picorubykaigi/adventure-board-pcb/production/pv1/bom.csv

Designator | Footprint | Quantity | Value | LCSC Part #
C1, C26, C3, C31, C32, C35, C36 | 0805 | 7 | 10uF | C1713
C10, C11, C12, C13, C14, C15, C16, C18, C19, C2, C23, C24, C28, C29, C30, C37, C38, C9 | 0402 | 18 | 100nF | C1525
C20, C21 | 0402 | 2 | 15pF | C1548
C22, C25 | 0402 | 2 | 3.3nF | C3881585
C27, C33, C34 | 0402 | 3 | 1uF | C52923
C4 | 0805 | 1 | 22uF | C45783
C5, C6, C7, C8 | 0402 | 4 | 4.7uF | C23733
D2 | 0603 | 1 | LED RED | C2286
D3 | 0805 | 1 | LED GREEN | C2297
J1 | PinSocket_2x10_P2.54mm_Vertical | 1 | BreadboardHdr_2x10 | C2897411
J4, J5 | CONN-SMD_HY2.0-4P | 2 | HY2.0-4P-WT | C722729
L1 | IND-SMD_L2.0-W1.6_AOTA-B201610S3R3-101-T | 1 | 3.3uH | C42411119
LED1, LED10, LED100, LED101, LED102, LED103, LED104, LED105, LED106, LED107, LED108, LED109, LED11, LED110, LED111, LED112, LED113, LED114, LED115, LED116, LED117, LED118, LED119, LED12, LED120, LED121, LED122, LED123, LED124, LED125, LED126, LED127, LED128, LED129, LED13, LED130, LED131, LED132, LED133, LED134, LED135, LED136, LED137, LED138, LED139, LED14, LED140, LED141, LED142, LED143, LED144, LED145, LED146, LED147, LED148, LED149, LED15, LED150, LED151, LED152, LED153, LED154, LED155, LED156, LED157, LED158, LED159, LED16, LED160, LED161, LED162, LED163, LED164, LED165, LED166, LED167, LED168, LED169, LED17, LED170, LED171, LED172, LED173, LED174, LED175, LED176, LED177, LED178, LED179, LED18, LED180, LED181, LED182, LED183, LED184, LED185, LED186, LED187, LED188, LED189, LED19, LED190, LED191, LED192, LED193, LED194, LED195, LED196, LED197, LED198, LED199, LED2, LED20, LED200, LED201, LED202, LED203, LED204, LED205, LED206, LED207, LED208, LED209, LED21, LED210, LED211, LED212, LED213, LED214, LED215, LED216, LED217, LED218, LED219, LED22, LED220, LED221, LED222, LED223, LED224, LED225, LED226, LED227, LED228, LED229, LED23, LED230, LED231, LED232, LED233, LED234, LED235, LED236, LED237, LED238, LED239, LED24, LED240, LED241, LED242, LED243, LED244, LED245, LED246, LED247, LED248, LED249, LED25, LED250, LED251, LED252, LED253, LED254, LED255, LED256, LED26, LED27, LED28, LED29, LED3, LED30, LED31, LED32, LED33, LED34, LED35, LED36, LED37, LED38, LED39, LED4, LED40, L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 | LED_0402_Compact_P1.6mm | 200 | LED_W | C20613596
LED49, LED5, LED50, LED51, LED52, LED53, LED54, LED55, LED56, LED57, LED58, LED59, LED6, LED60, LED61, LED62, LED63, LED64, LED65, LED66, LED67, LED68, LED69, LED7, LED70, LED71, LED72, LED73, LED74, LED75, LED76, LED77, LED78, LED79, LED8, LED80, LED81, LED82, LED83, LED84, LED85, LED86, LED87, LED88, LED89, LED9, LED90, LED91, LED92, LED93, LED94, LED95, LED96, LED97, LED98, LED99 | LED_0402_Compact_P1.6mm | 56 | LED_W | C20613596
LS1 | BUZ-SMD_4P-L13.0-W13.0-P11.4-BL | 1 | SPK_8R_0.7W | C18186315
R1, R2 | 0402 | 2 | 5.1k | C25905
R10, R14, R43, R7, R8 | 0402 | 5 | 1k | C11702
R11, R12 | 0402 | 2 | 2.2k | C25879
R13, R15, R29, R30 | 0402 | 4 | 4.7k | C25900
R17, R18 | 0402 | 2 | 33k | C25779
R19, R24, R33, R34, R35, R36, R37, R38 | 0402 | 8 | 10k | C25744
R20, R21, R22, R23 | 0402 | 4 | 22 | C25092
R25, R27, R28, R48, R49 | 0603 | 5 | 0 | C21189
R3, R4 | 0402 | 2 | 27 | C25100
R31, R32 | 0402 | 2 | 2k | C4109
R5 | 0402 | 1 | 33 | C25105
R6, R9 | 0402 | 2 | 47k | C25792
SW1, SW2, SW3, SW4, SW5, SW6 | KEY-SMD_4P-L6.0-W6.0-P4.50-LS8.6 | 6 | SW_MEC_5G | C381038
SW7 | SW-SMD_L3.9-W3.0-P4.45 | 1 | BOOTSEL | C720477
SW8 | SW-SMD_L3.9-W3.0-P4.45 | 1 | RESET | C720477
U1 | RP2350-QFN-60-1EP_7x7_P0.4mm_EP3.4x3.4mm_ThermalVias | 1 | RP2350A | C42411118
U10, U11 | QFN-32_L4.0-W4.0-P0.40-TL-EP2.8 | 2 | IS31FL3729 | C2940549
U2 | SOD-323_L1.8-W1.3-LS2.7-BI | 1 | H5VHD3BC | C20615804
U3 | USB-C-SMD_G-SWITCH_GT-USB-7010ASV | 1 | GT-USB-7010ASV | C2988369
U4 | SOIC-8_L5.3-W5.3-P1.27-LS8.0-BL | 1 | W25Q64JVSSIQ | C179171
U6 | SOT-23-3_L2.9-W1.3-P1.90-LS2.4-BR | 1 | PESD5V0U2BT | C2905622
U7 | SOT-23-5 | 1 | TPS2065CDBV | C353882
U8 | MSOP-8_L3.0-W3.0-P0.65-LS5.0-BL | 1 | PAM8302AASCR | C113367
U9 | SOT-223-3_L6.5-W3.4-P2.30-LS7.0-BR | 1 | AMS1117-3.3 | C6186
Y1 | CRYSTAL-SMD_4P-L3.2-W2.5-BL | 1 | 12MHz | C20625731
