picorubykaigi/adventure-board-pcb/docs/adventure-board-schematic.pdf

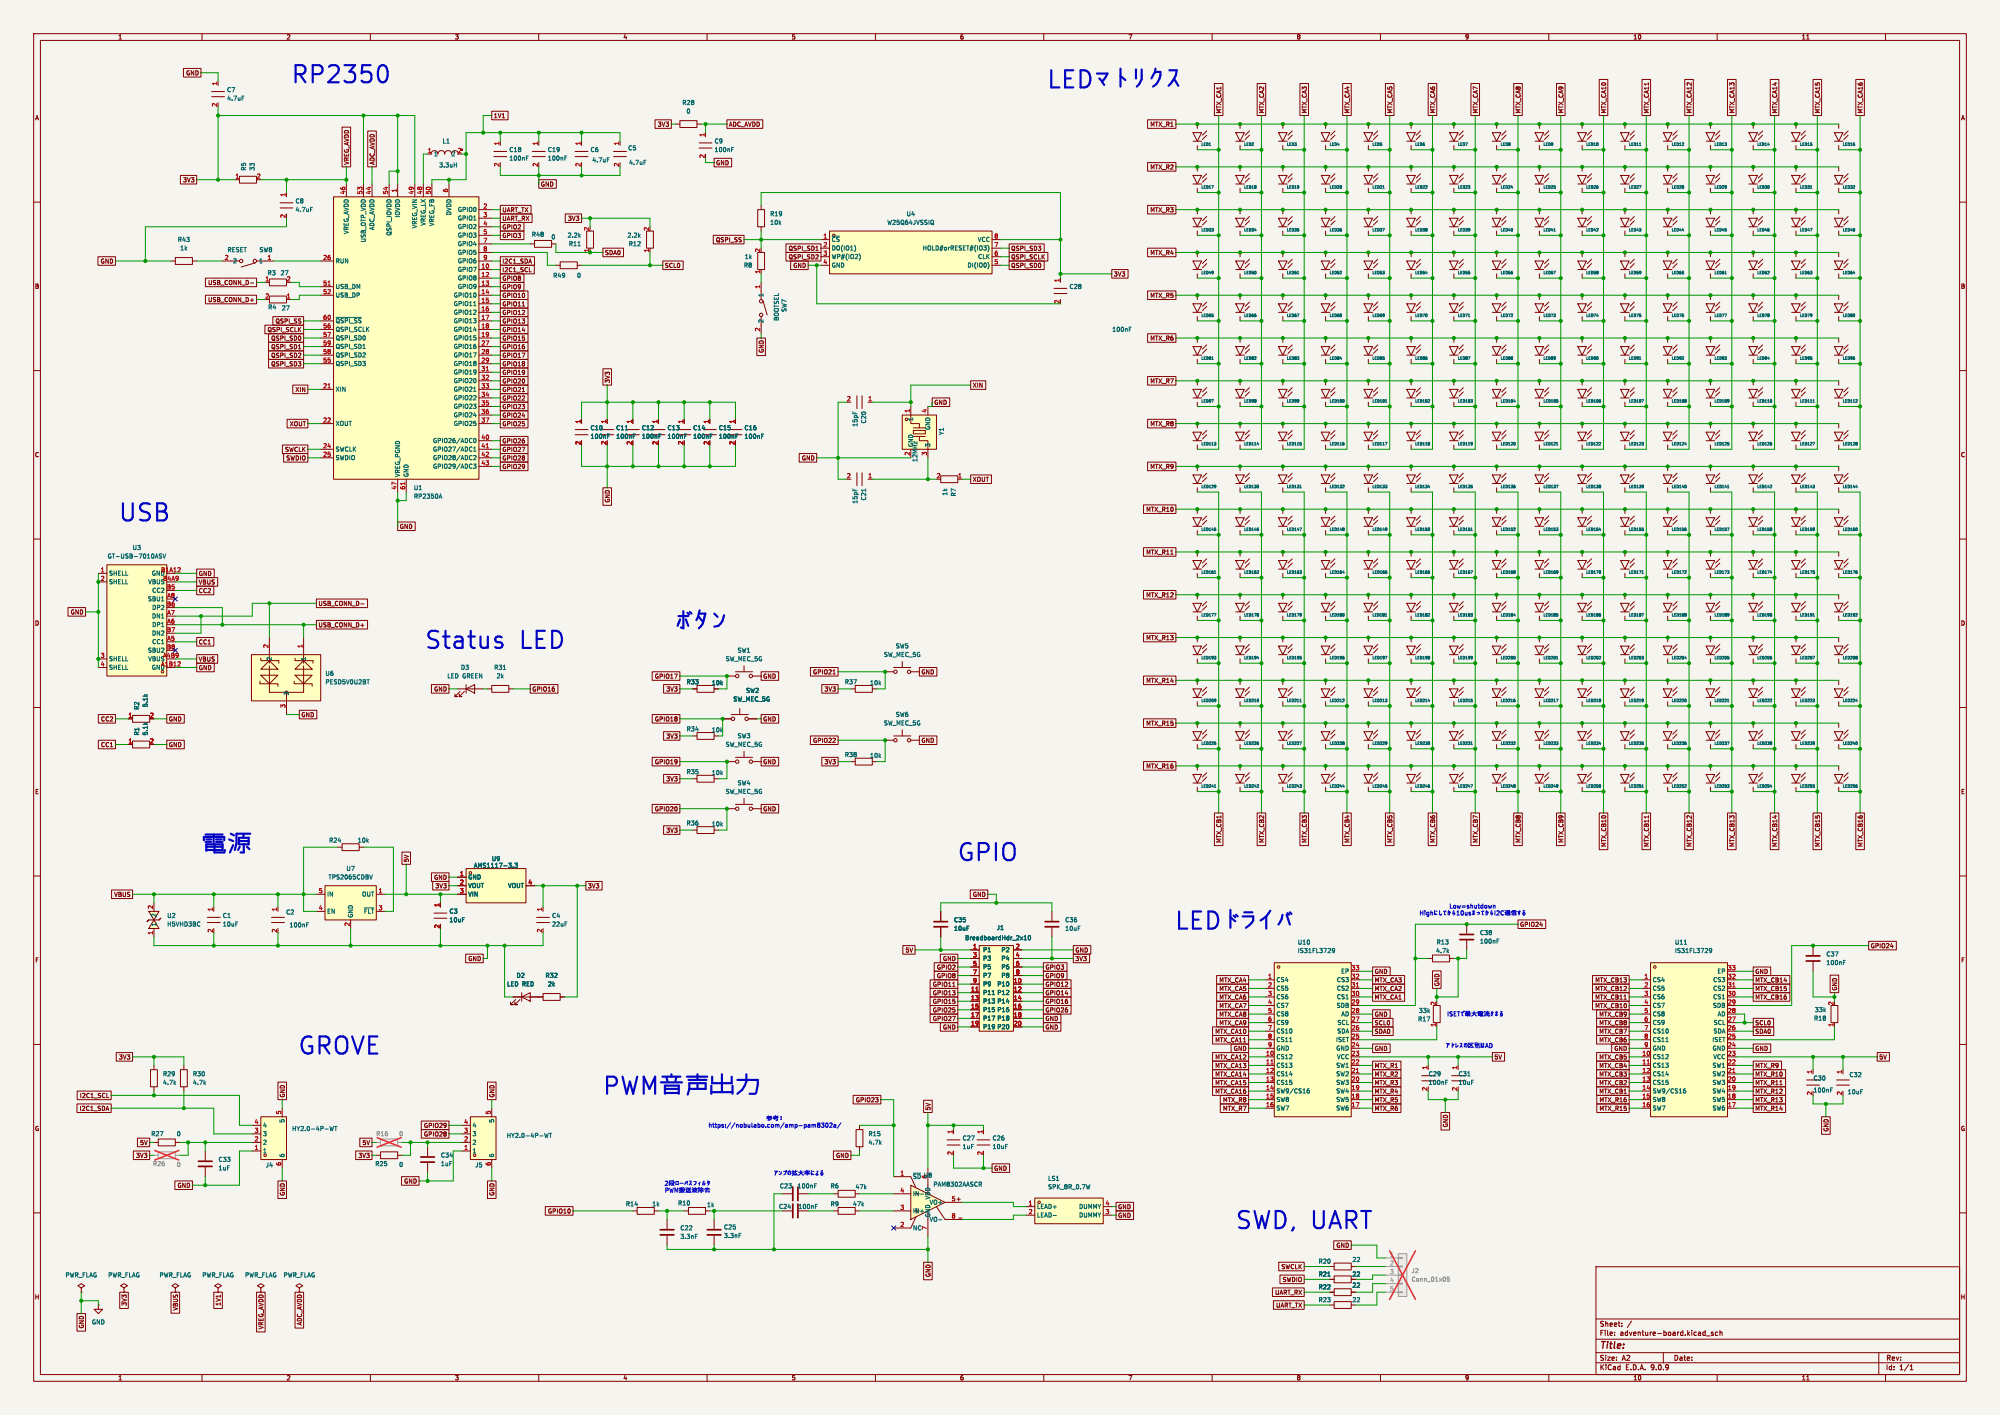
[picture p1: page 1]

6 RUN 26 USB_DM 51 USB_DP 52 ~{QSPI_SS} 60 QSPI_SCLK 56 QSPI_SD0 57 QSPI_SD1 59 QSPI_SD2 58 QSPI_SD3 55 XIN 21 XOUT 22 SWCLK 24 SWDIO 25 ADC_AVDD 44 IOVDD

https://nobulabo.com/amp-pam8302a/
