picorubykaigi/adventure-board-pcb/(commit log)

2026-09-26 Add PV1 design data
    Imported from picorubykaigi01-board@07cbfc6 (= PV1 tag, renamed to
    adventure-board). 3D models are not included. Gerber/drill files are
    byte-identical to the PV1 order; only file names were changed.
    Licensed under CERN-OHL-P v2.
2026-10-03 Add V1 (mass production) design data
    - Move the two bottom mounting holes to 4.5 mm from the corners, matching the top ones
    - Remove the "PV1" silkscreen marking
    - Add production/v1 fabrication data and point README to it
2026-10-03 Add schematic PDF to production/v1
2026-10-19 Fix 'Staus' typo in schematic, drop reorder steps from README
    Regenerate the schematic PDFs with kicad-cli 9.0.
